tana/balance-robot2/kicad/BalanceRobot.kicad_pcb

## KiCad design kicad/BalanceRobot.kicad_pcb (2022-12-21)

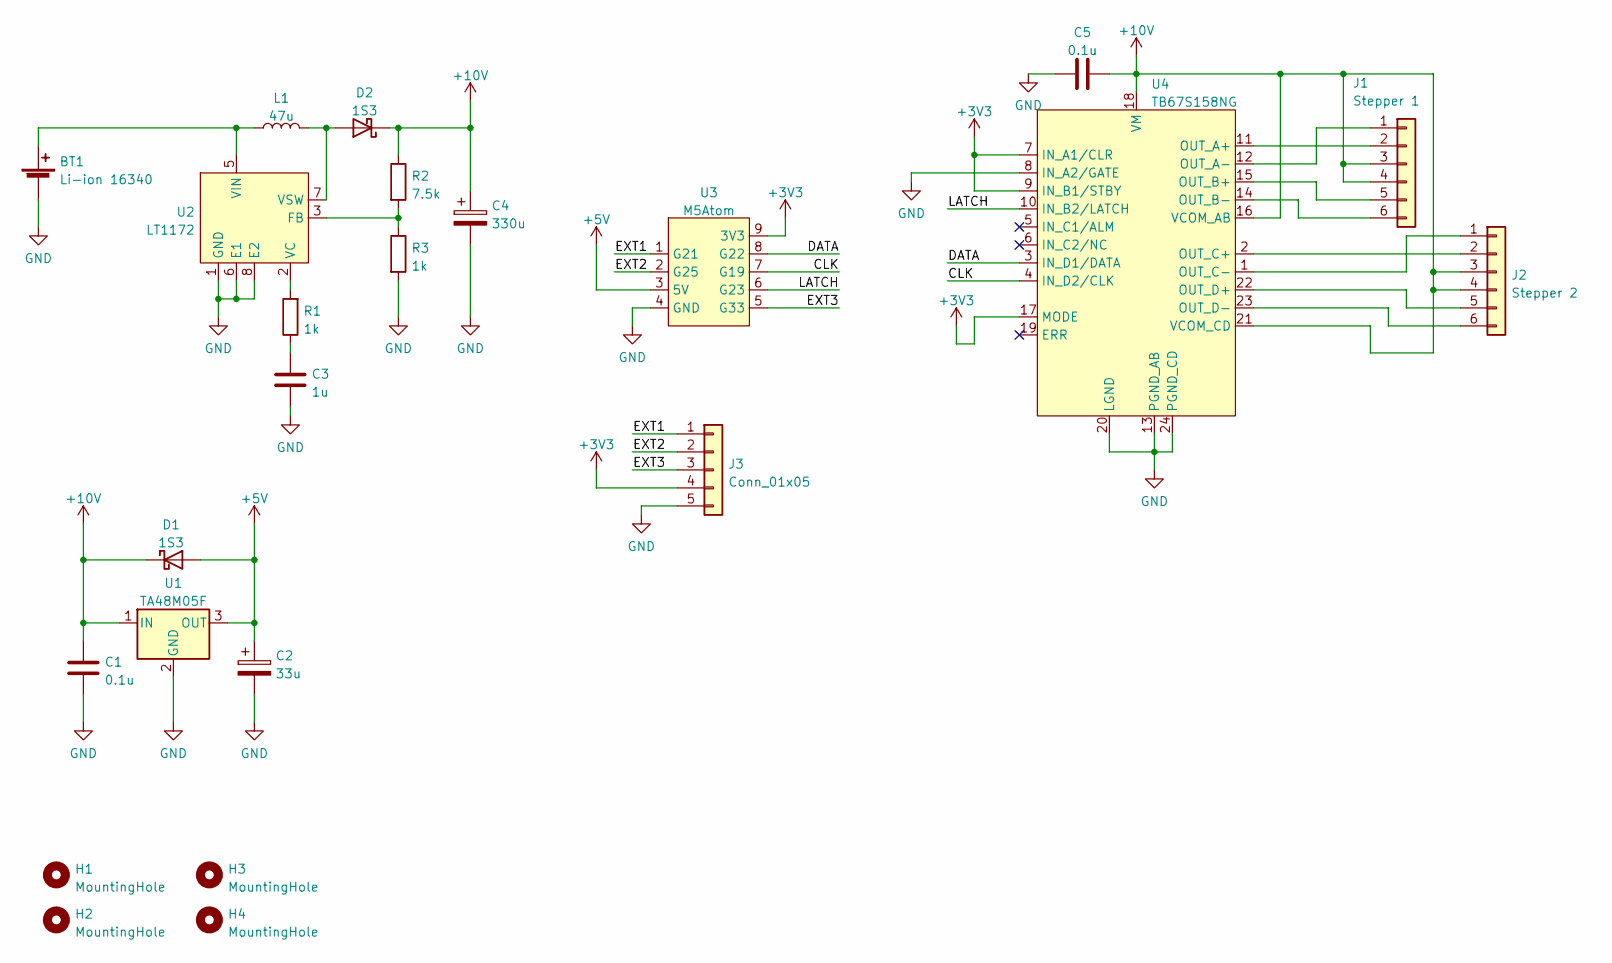
[picture p2: schematic BalanceRobot.kicad_sch]

Parts:
BT1: Li-ion 16340; Takachi_CR123A-PC
C1, C5: 0.1u; C_Disc_D3.0mm_W1.6mm_P2.50mm
C2: 33u; CP_Radial_D5.0mm_P2.50mm
C3: 1u; C_Disc_D3.0mm_W1.6mm_P2.50mm
C4: 330u; CP_Radial_D8.0mm_P5.00mm
D1, D2: 1S3; D_DO-34_SOD68_P7.62mm_Horizontal
H1, H2, H3, H4: MountingHole; MountingHole_3.2mm_M3
J1: Stepper 1; PinHeader_1x06_P2.54mm_Vertical
J2: Stepper 2; PinHeader_1x06_P2.54mm_Vertical
J3: Conn_01x05; PinHeader_1x05_P2.54mm_Vertical
L1: 47u; L_Radial_D10.5mm_P5.00mm_Abacron_AISR-01
R1, R3: 1k; R_Axial_DIN0207_L6.3mm_D2.5mm_P7.62mm_Horizontal
R2: 7.5k; R_Axial_DIN0207_L6.3mm_D2.5mm_P7.62mm_Horizontal
U1: TA48M05F; TO-251-3_Vertical
U2: LT1172; DIP-8_W7.62mm
U3: M5Atom
U4: TB67S158NG; SDIP24_300mil

Connections:
+3V3: J3.4, U3.9 (3V3), U4.7 (IN_A1/CLR), U4.9 (IN_B1/STBY), U4.17 (MODE)
+5V: C2.1, D1.2 (A), U1.3 (OUT), U3.3 (5V)
+10V: C1.1, C4.1, C5.2, D1.1 (K), D2.1 (K), J1.3, J1.4, J2.3, J2.4, R2.1, U1.1 (IN), U4.16 (VCOM_AB), U4.18 (VM), U4.21 (VCOM_CD)
/CLK: U3.7 (G19), U4.4 (IN_D2/CLK)
/DATA: U3.8 (G22), U4.3 (IN_D1/DATA)
/EXT1: J3.1, U3.1 (G21)
/EXT2: J3.2, U3.2 (G25)
/EXT3: J3.3, U3.5 (G33)
/LATCH: U3.6 (G23), U4.10 (IN_B2/LATCH)
GND: BT1.2 (-), C1.2, C2.2, C3.2, C4.2, C5.1, J3.5, R3.2, U1.2 (GND), U2.1 (GND), U2.6 (E1), U2.8 (E2), U3.4 (GND), U4.8 (IN_A2/GATE), U4.13 (PGND_AB), U4.20 (LGND), U4.24 (PGND_CD)
unnamed: BT1.1 (+), L1.1, U2.5 (VIN)
unnamed: C3.1, R1.1
unnamed: D2.2 (A), L1.2, U2.7 (VSW)
unnamed: J1.1, U4.12 (OUT_A-)
unnamed: J1.2, U4.11 (OUT_A+)
unnamed: J1.5, U4.15 (OUT_B+)
unnamed: J1.6, U4.14 (OUT_B-)
unnamed: J2.1, U4.1 (OUT_C-)
unnamed: J2.2, U4.2 (OUT_C+)
unnamed: J2.5, U4.22 (OUT_D+)
unnamed: J2.6, U4.23 (OUT_D-)
unnamed: R1.2, U2.2 (VC)
unnamed: R2.2, R3.1, U2.3 (FB)

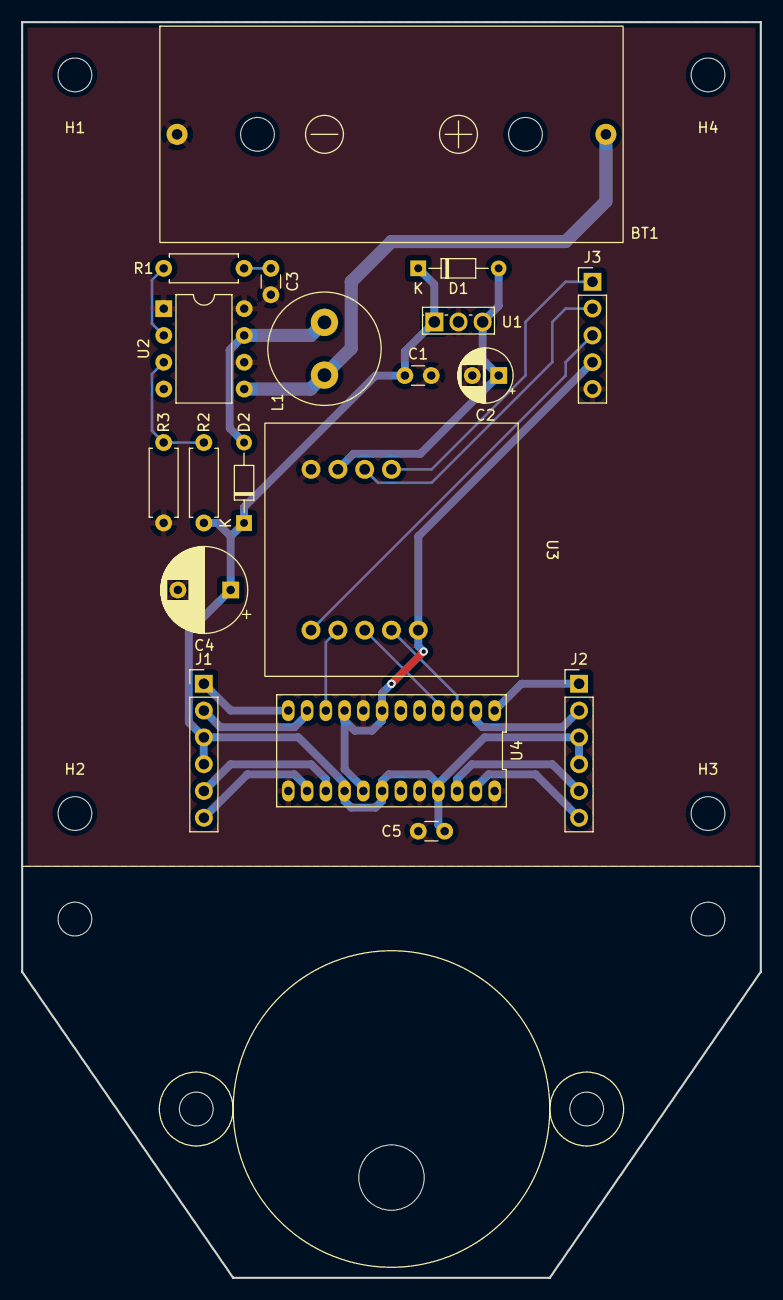
[picture p3: board BalanceRobot.kicad_pcb from above]

Board: 2 copper layers, 70.0 x 119.0 mm, 23 parts (0 on the bottom side), 23 nets.
