tana/balance-robot2/(commit log)

2022-12-20 Stepper driver
2022-12-21 Add KiCad files
    [BalanceRobot.kicad_pcb, BalanceRobot.kicad_sch]
2022-12-22 Fix bit order of steppers
    [main.rs, shift_stepper.rs]
2022-12-22 Update schematic to reflect actual values
    [BalanceRobot.kicad_sch]
2022-12-29 Constant speed pulse generation for steppers
2022-12-29 Button for toggling motor on/off
2022-12-30 Use filtered angular velocity
2023-01-03 Change gain and some fixes
    [main.rs]
2023-01-03 Revert "Implement microstepping"
    This reverts commit 56e40cff70498bef762ddbb85099dc7a059d9d55.
    [main.rs, shift_stepper.rs]
2023-01-03 Revert "(WIP) microstepping"
    This reverts commit 665b255de0fa59d8b344f2f43de44f53dec14450.
    [main.rs, shift_stepper.rs]
2023-01-03 Include custom KiCad libraries
2023-01-09 Implement turn. A bit unstable
    [main.rs]
2023-01-09 Fix turn limit calculation
    [main.rs]
2023-01-09 Fix crash on Wi-Fi connect/disconnect
    [main.rs]
